keysie/Astro-Mount-EQ3/hardware/dc-dc-converter/closeup.jpg

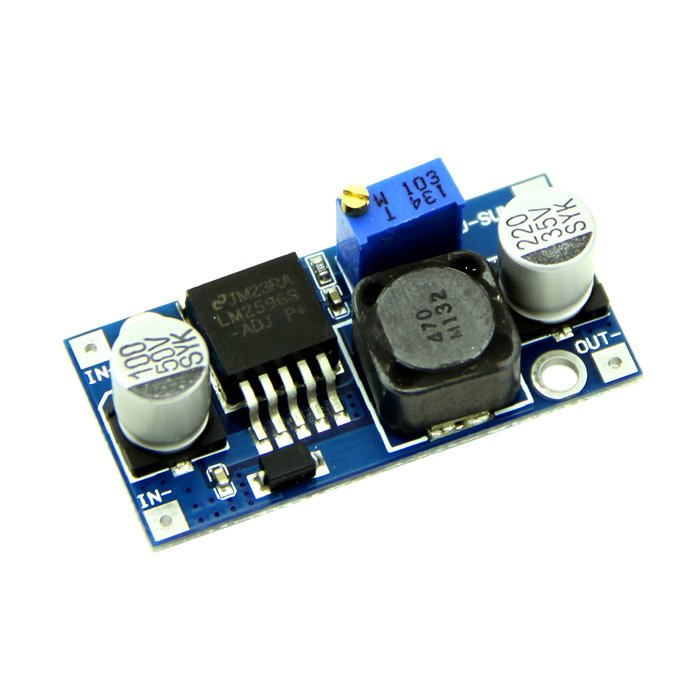
hardware/dc-dc-converter/closeup.jpg
