keysie/Astro-Mount-EQ3/hardware/dc-motor/closeup.JPG

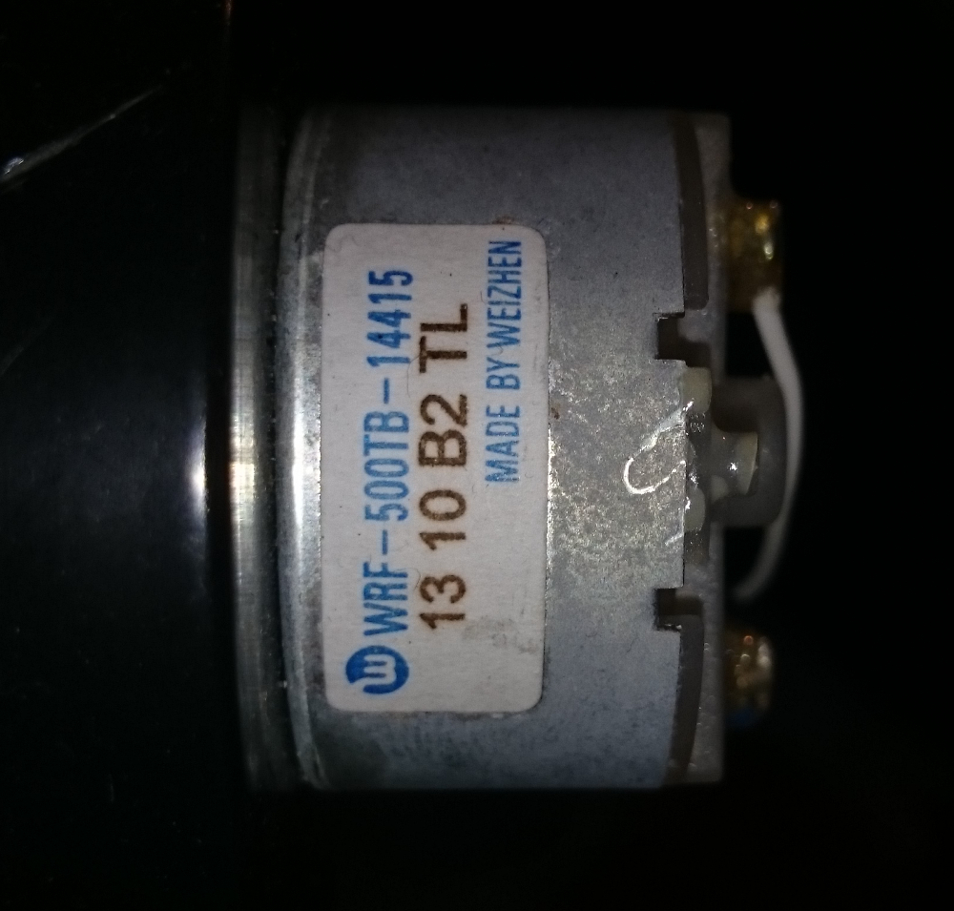
hardware/dc-motor/closeup.JPG
