keysie/Astro-Mount-EQ3/hardware/gear/gear-ratios.ods

Sprocket | Teeth | Ratio | Seconds per encoder tick
Ritzel Motor | 15
1. gross | 58 | 3.8666666667 | 0.000622456155
1. klein | 13
2. gross | 58 | 4.4615384615 | 0.002777112076
2. klein | 13
3. gross | 58 | 4.4615384615 | 0.012390192339
3. klein | 13
4. gross | 58 | 4.4615384615 | 0.055279319667
4. klein | 17
5. gross | 58 | 3.4117647059 | 0.188600031806 | <--- Encoder
5. klein | 13
6. gross | 58 | 4.4615384615 | 0.841446295750
6. klein | 13
Abtrieb | 52 | 4 | 3.365785183000
 |  | 20908.090104496
