keysie/Astro-Mount-EQ3/hardware/arduino/arduino-uno-r3-schematic-changed.pdf

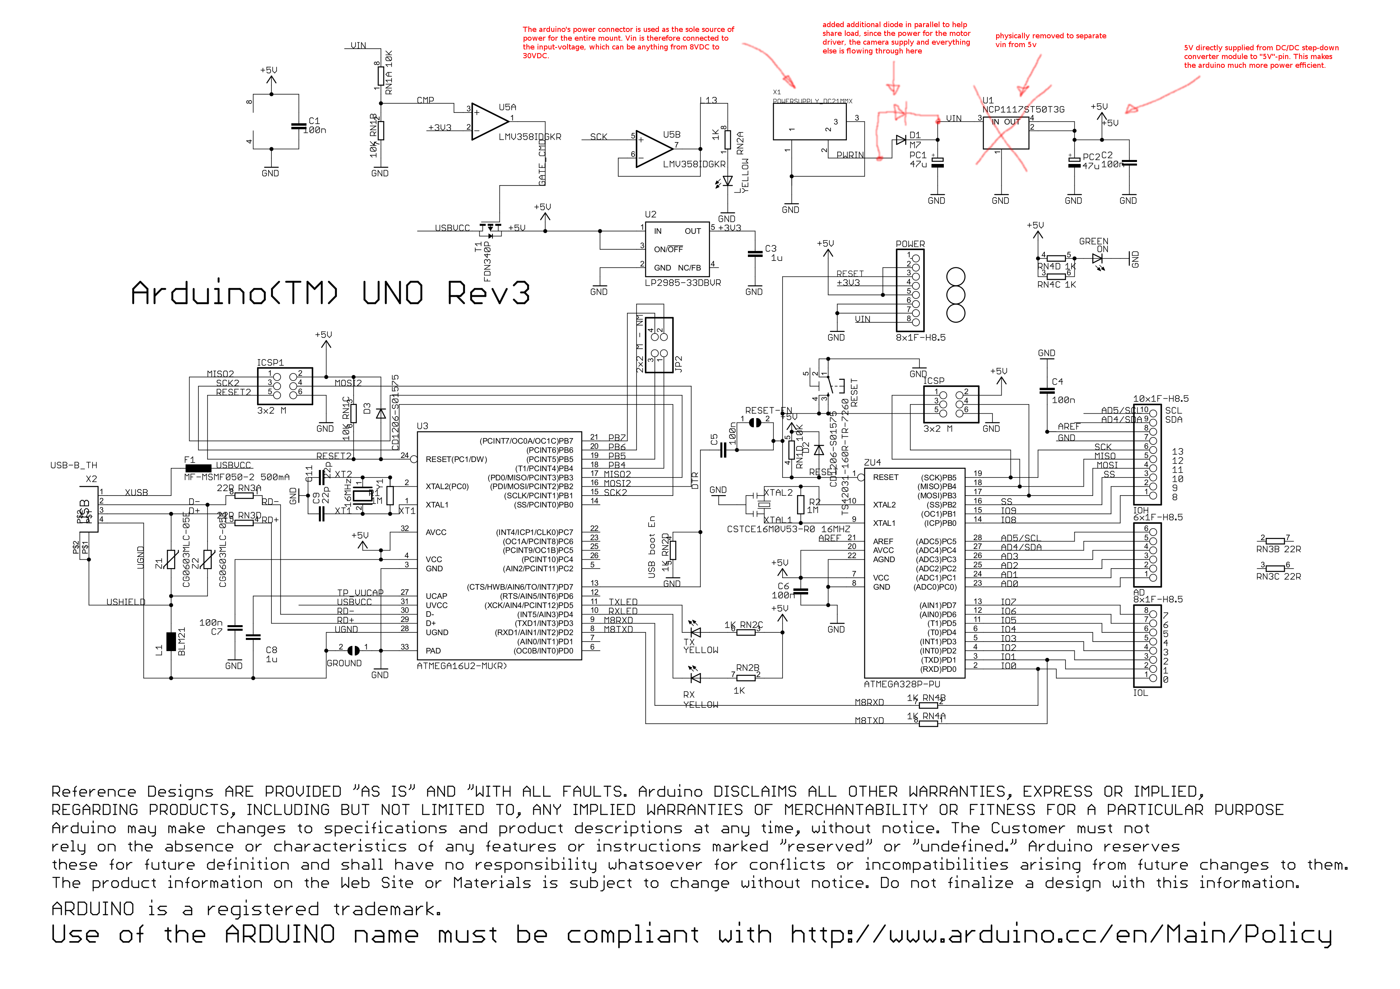
[picture p3: page 1]
