keysie/Astro-Mount-EQ3/doc/angular-velocity-calculation.jpg

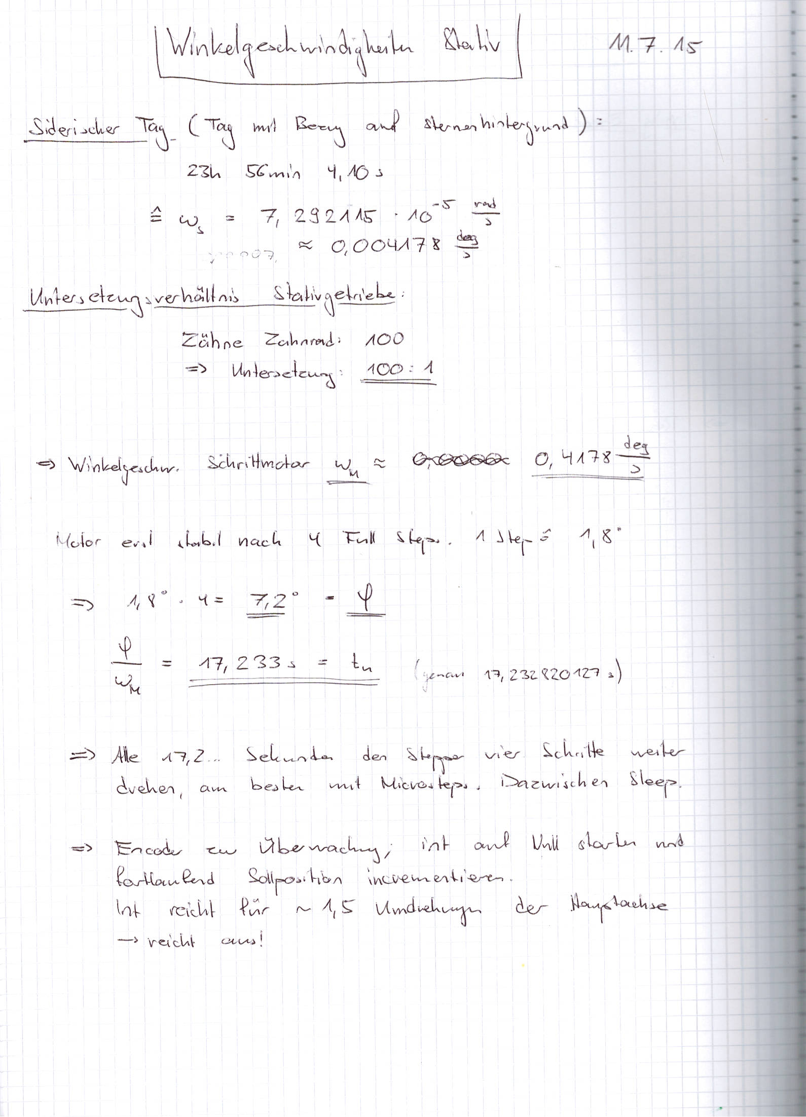
doc/angular-velocity-calculation.jpg
