keysie/Astro-Mount-EQ3/hardware/camera-power-supply/schematic.jpg

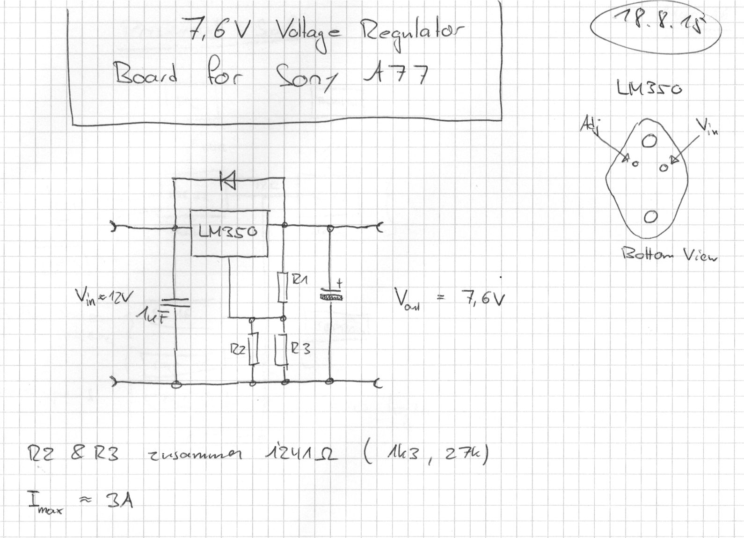
hardware/camera-power-supply/schematic.jpg
