keysie/Astro-Mount-EQ3/hardware/dc-dc-converter/details.jpg

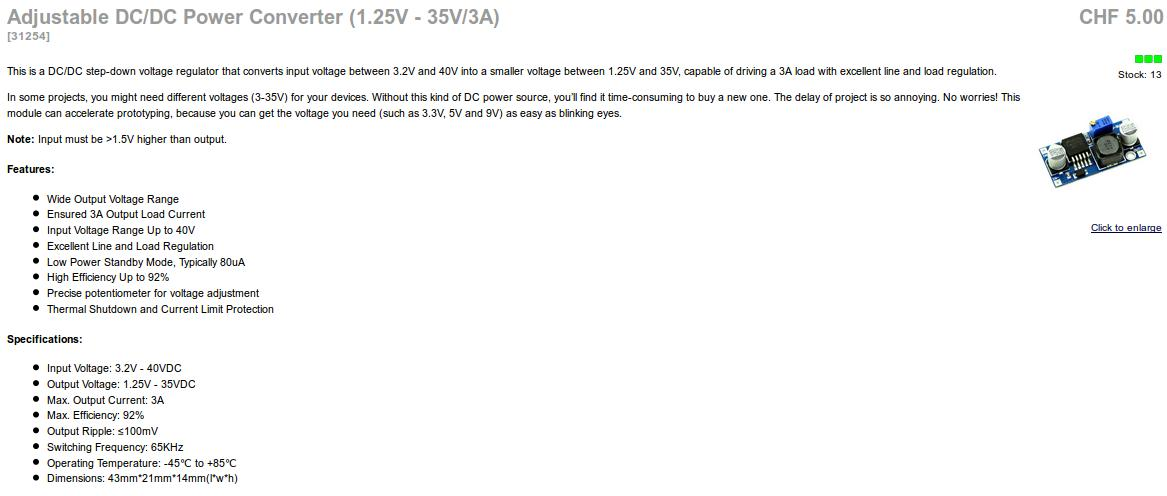
hardware/dc-dc-converter/details.jpg
