keysie/Astro-Mount-EQ3/hardware/dc-motor/datasheet.png

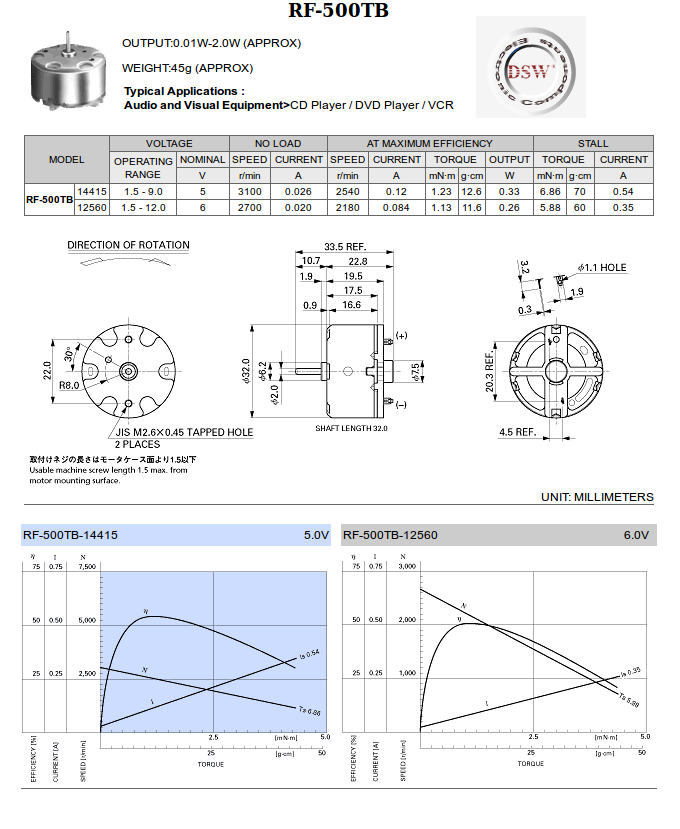
hardware/dc-motor/datasheet.png
