keysie/Astro-Mount-EQ3/hardware/driver/datasheet.png

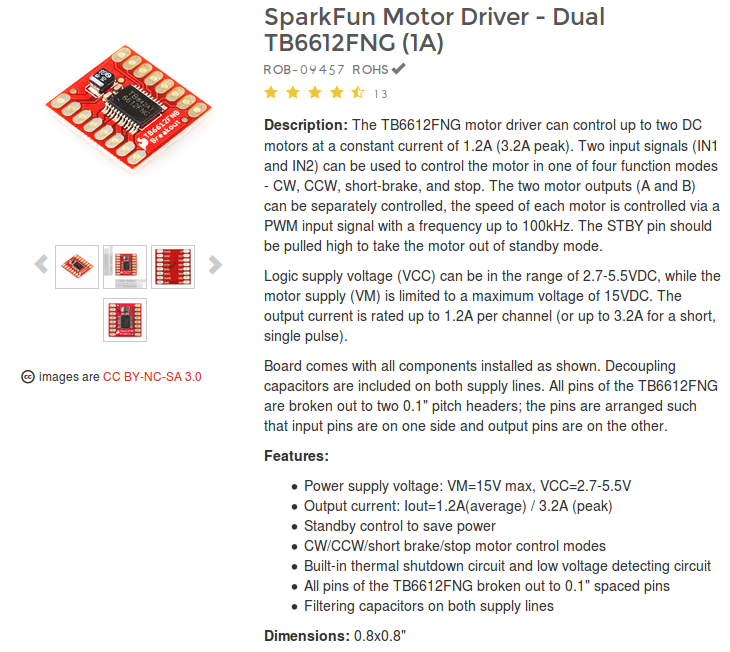
hardware/driver/datasheet.png
