keysie/Astro-Mount-EQ3/hardware/encoder/encoder-cheatsheet.jpg

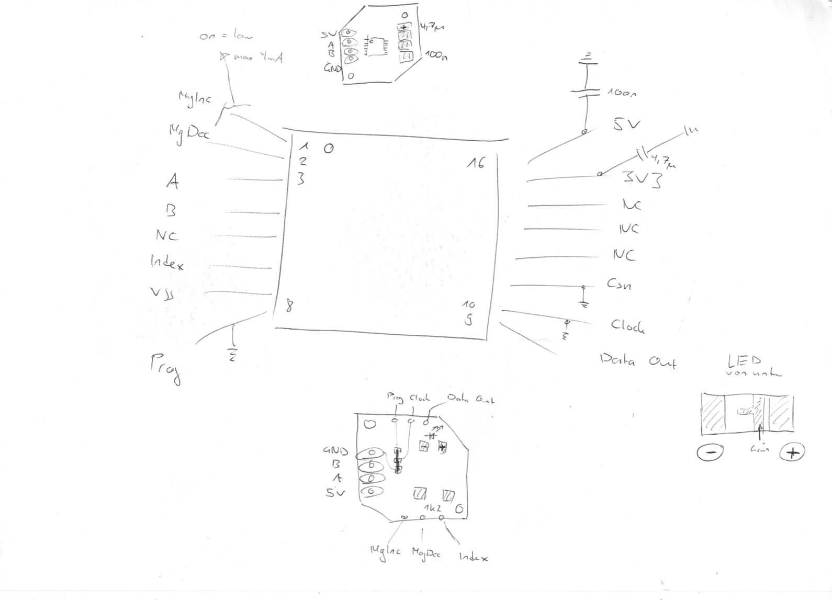
hardware/encoder/encoder-cheatsheet.jpg
