keysie/Astro-Mount-EQ3/hardware/external-clock/description.jpg

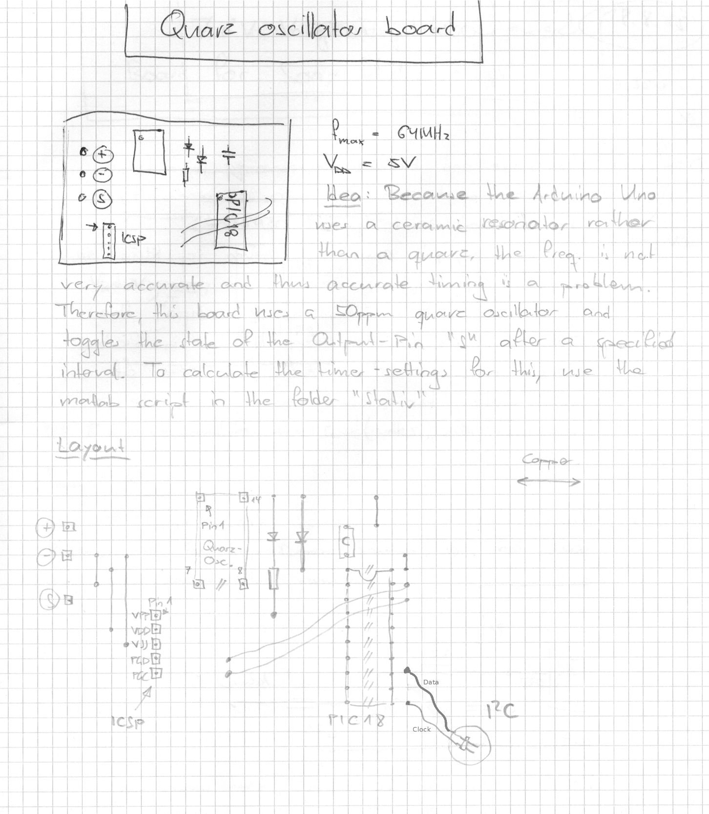
hardware/external-clock/description.jpg
