keysie/Astro-Mount-EQ3/hardware/external-clock/layout.jpg

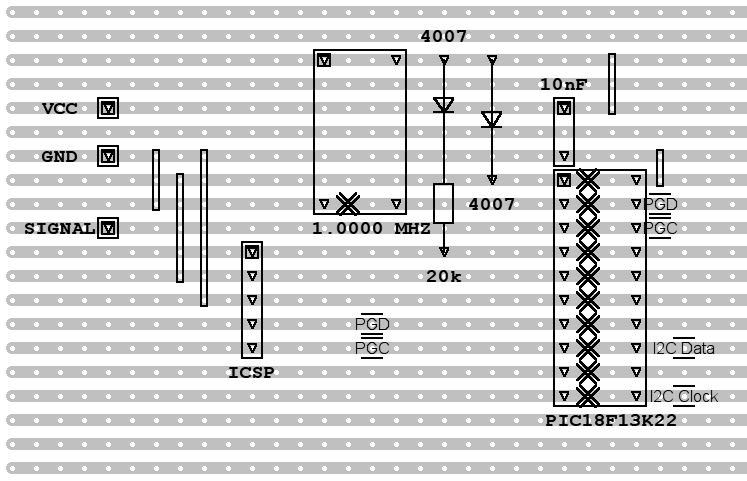
hardware/external-clock/layout.jpg
