keysie/Astro-Mount-EQ3/(list of files, cad)

Other CAD files:
hardware/external-clock/Code/Stativ_Cristal_Timer.X/dist/default/production/Stativ_Cristal_Timer.X.production.obj
