keysie/Astro-Mount-EQ3/hardware/driver/schematic.pdf

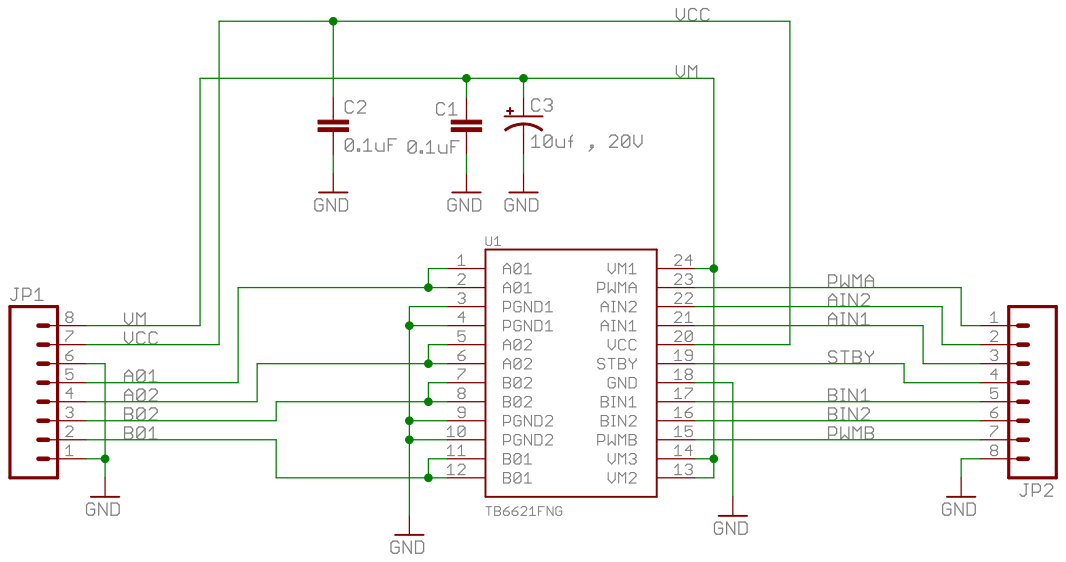
[picture p12: page 1]
