keysie/Astro-Mount-EQ3/hardware/encoder/Schematic&Layout/V05.brd

## EAGLE design hardware/encoder/Schematic&Layout/V05.brd (2016-04-09)

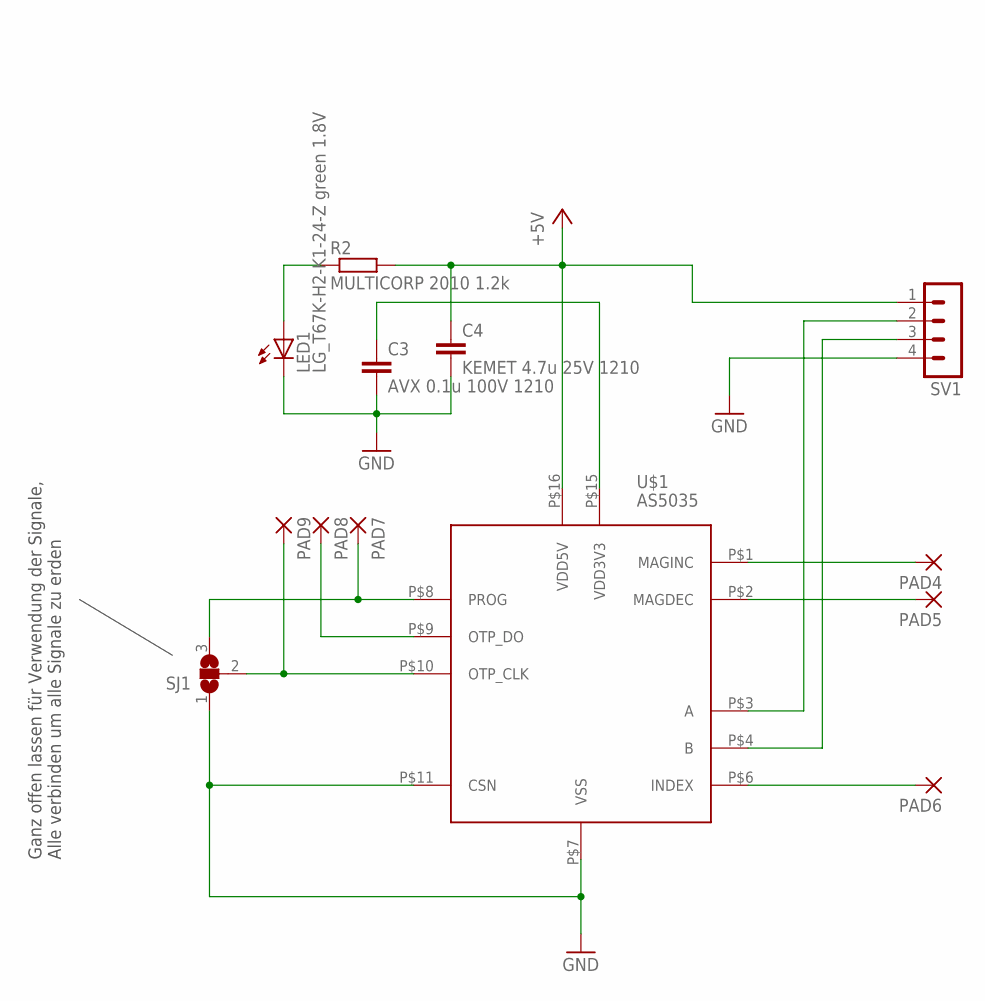
[picture p13: schematic V05.sch]

Parts:
C3: AVX 0.1u 100V 1210; C1210
C4: KEMET 4.7u 25V 1210; C1210
LED1: LG_T67K-H2-K1-24-Z green 1.8V; PLCC2
PAD4, PAD5, PAD6, PAD7, PAD8, PAD9: 1,6/0,8
R2: MULTICORP 2010 1.2k; R2010
SJ1: SJ2W; SJ_2
SV1: MA04-1
U$1: AS5035; TSSOP-16

Connections:
+5V: C4.1, R2.2, SV1.1, U$1.P$16 (VDD5V)
GND: C3.2, C4.2, LED1.C, SJ1.1, SV1.4, U$1.P$7 (VSS), U$1.P$11 (CSN)
unnamed: C3.1, U$1.P$15 (VDD3V3)
unnamed: PAD4.1, U$1.P$1 (MAGINC)
unnamed: PAD5.1, U$1.P$2 (MAGDEC)
unnamed: PAD6.1, U$1.P$6 (INDEX)
unnamed: PAD9.1, SJ1.2, U$1.P$10 (OTP_CLK)
unnamed: LED1.A, R2.1
unnamed: SV1.3, U$1.P$4 (B)
unnamed: SV1.2, U$1.P$3 (A)
unnamed: PAD7.1, SJ1.3, U$1.P$8 (PROG)
unnamed: PAD8.1, U$1.P$9 (OTP_DO)

Notes on the sheet:
Ganz offen lassen für Verwendung der Signale, Alle verbinden um alle Signale zu erden

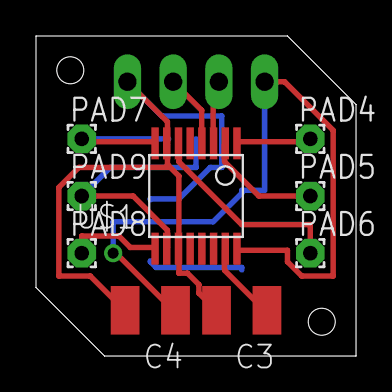
[picture p14: board V05.brd from above]

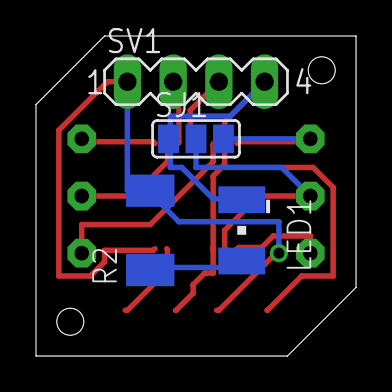
[picture p15: board V05.brd from below]

Board: 2 copper layers, 17.8 x 17.8 mm, 13 parts (4 on the bottom side), 12 nets.
