keysie/Astro-Mount-EQ3/hardware/dc-dc-converter/step-down-converter-addition.jpg

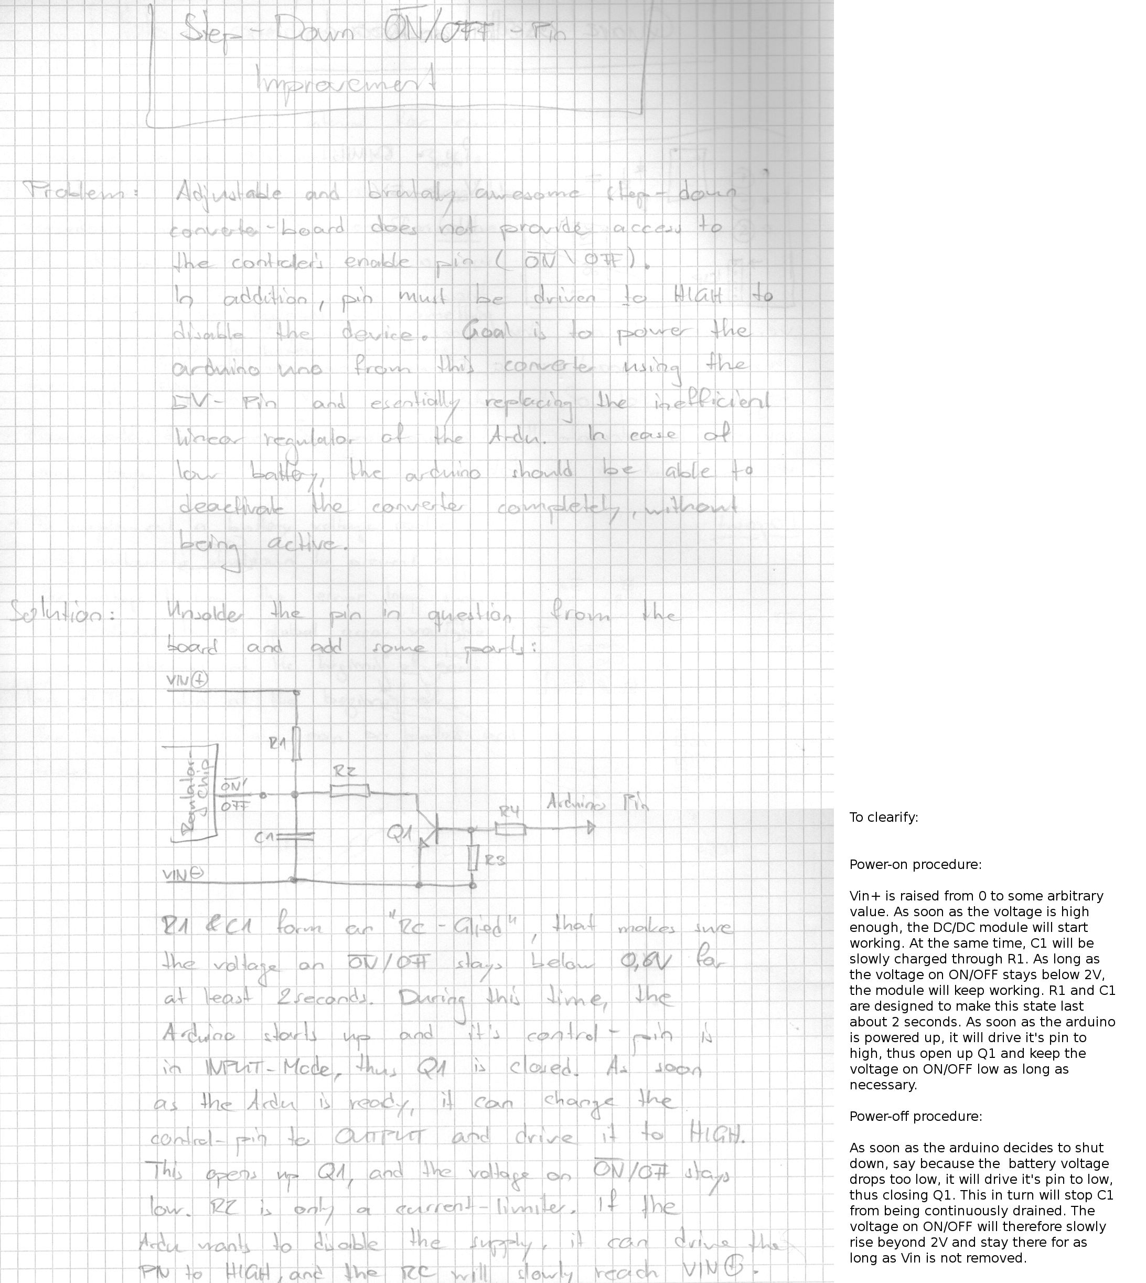
hardware/dc-dc-converter/step-down-converter-addition.jpg
