keysie/Astro-Mount-EQ3/hardware/hardware-setup.jpg

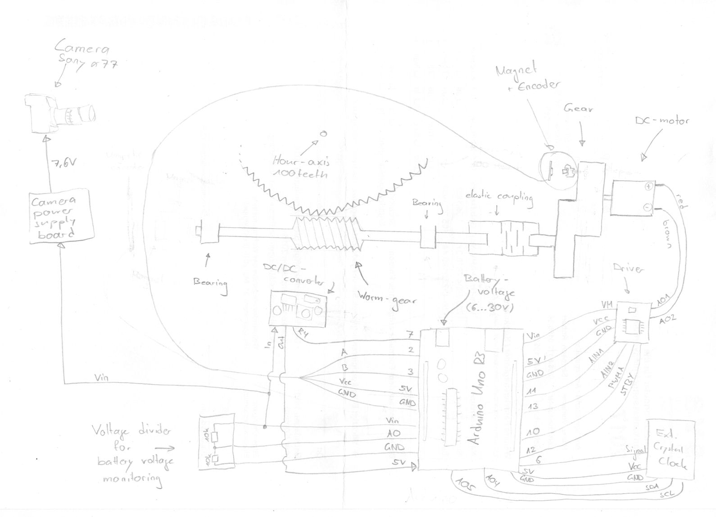
hardware/hardware-setup.jpg
