keysie/Astro-Mount-EQ3/test-sketches/Serial_Timing_Tester/Serial_Timing_Tester.ino

// t_soll = 1.2800000 s
// prescaler = 1024

boolean output = false;

void setup()
{
  Serial.begin(115200);
  
  cli();//stop interrupts

  //set timer1 interrupt at 1Hz
  TCCR1A = 0;// set entire TCCR1A register to 0
  TCCR1B = 0;// same for TCCR1B
  TCNT1  = 0;//initialize counter value to 0
  // set compare match register
  OCR1A = 19999;// = (16*10^6) / (1*1024) - 1 (must be <65536)
  // turn on CTC mode
  TCCR1B |= (1 << WGM12);
  // Set CS12 and CS10 bits for 1024 prescaler
  TCCR1B |= (1 << CS12) | (1 << CS10);  
  // enable timer compare interrupt
  TIMSK1 |= (1 << OCIE1A);


  sei();//allow interrupts
}

ISR(TIMER1_COMPA_vect)
{
  output = true;
}

void loop()
{
  if (output == true)
  {
    Serial.println(1);
    output = false;
  }
}
