keysie/Astro-Mount-EQ3/(commit log)

2016-04-06 Most basic version
    No feedback, Stepper, internal arduino timing source
    No undervoltage protection
2016-04-07 v0.2a: exchanged stepper with dc-motor, PI control
    Even the smallest possible stepping of the stepper-motor is still to big for astrophotography, because there is no gear in between the motor and the worm-axis. Therefore replaced by dc motor with a gear. System is now in full feedback control loop with PI controller based on experiments and a MATLAB model. Sensor is still 256-tick encoder directly mounted to worm-axis.
    Arduino now outputs a steady stream of controller info such as desired vs measured position etc. on serial on 115200 baud.
    [interruptRoutines.ino, loopRoutines.ino, mount.ino, setupRoutines.ino]
2016-04-07 added description to mount.ino
2016-04-09 Added details of gear ratios
    [gears.ods]
2016-04-09 Added aditional hardware info
    [gear-ratios.ods, gears.ods]
2016-04-09 even more hardware info
    [A_V05_PCB.prt, C_1210_095.prt, Jumper_TH_2_Pin.prt, LED_3528.prt, R_2010.prt, TSSOP-16.prt, V01.brd, V01.sch]
2016-04-09 angular velocity documentation added
2016-04-10 compressed cad and old schematic data of encoder to conserve space
    [A_V05_PCB.prt, C_1210_095.prt, Jumper_TH_2_Pin.prt, LED_3528.prt, R_2010.prt, TSSOP-16.prt, V01.brd, V01.sch]
2016-04-10 folder renamed
    [V05.brd, V05.sch]
2016-04-10 Crystal clock board code added
    [Stativ_Cristal_Timer.X.production.obj]
2016-04-10 v0.2c: Encoder and magnet now placed on transmission gear to increase resolution. Also added camer power supply board.
2016-04-10 v0.2c hardware docu updated
    [gear-ratios.ods]
2016-04-10 v0.3: I2C-linkup, timing fixed
    [I2C.ino, mount.ino, setupRoutines.ino]
2016-04-10 various test-sketches and matlab script for timer calculation on PIC added
2016-04-10 restructured to comply with arduino studio sketchbook
